donatukas/Malahit/D.jpg

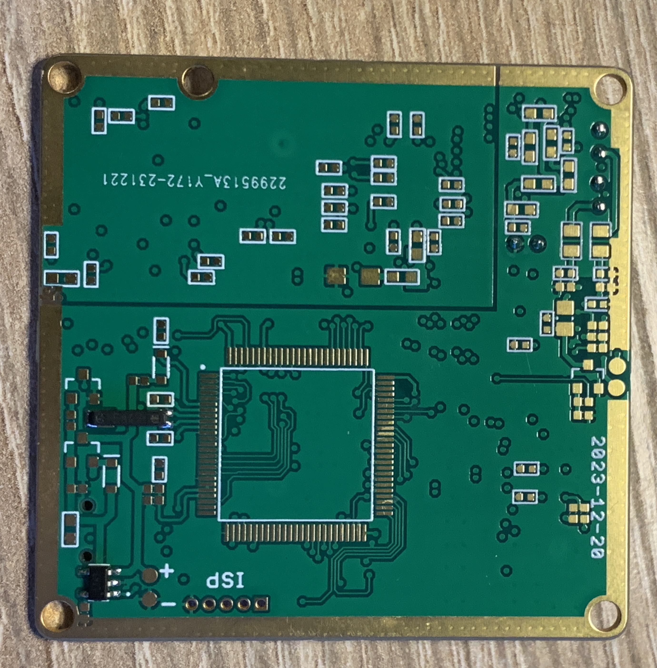
D.jpg
