donatukas/Malahit/C.jpg

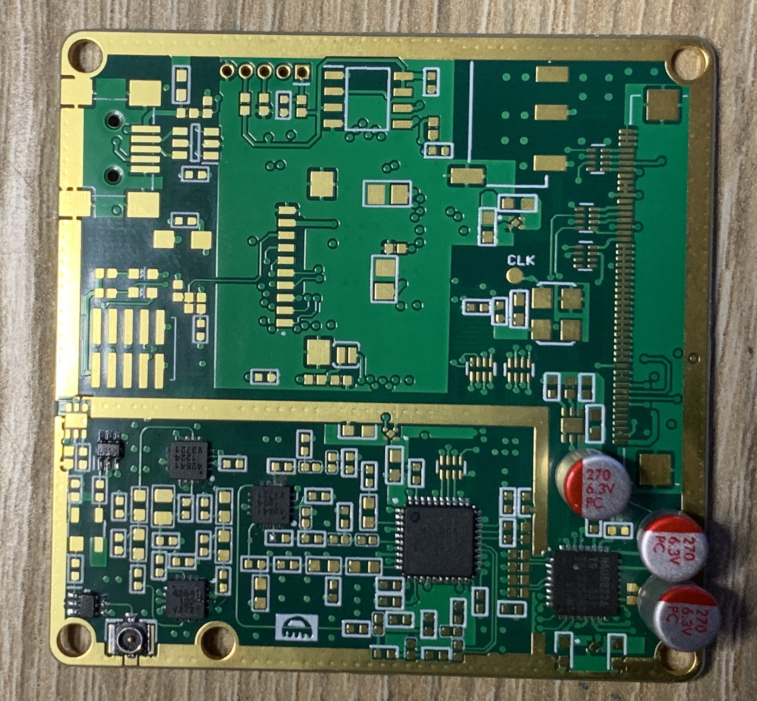
C.jpg
