donatukas/Malahit/README.md

     * Malachite SDR

     * 50KHz-250MHz+400-2000MHz DSP SDR Receiver
     * DSP SDR Receiver for Malahit
     * Capacitive touch screen
     * Flash via USB cable
     * Default frequency range: 50KHz-2000MHz
     * 3.5 inch capacitive screen
