donatukas/Malahit/A.png

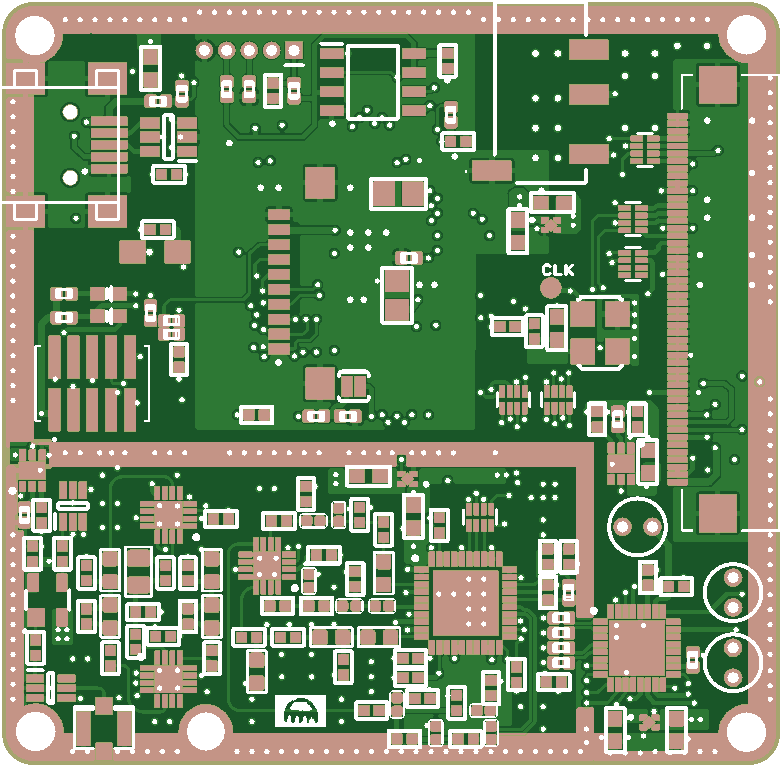
A.png
