donatukas/Malahit/B.png

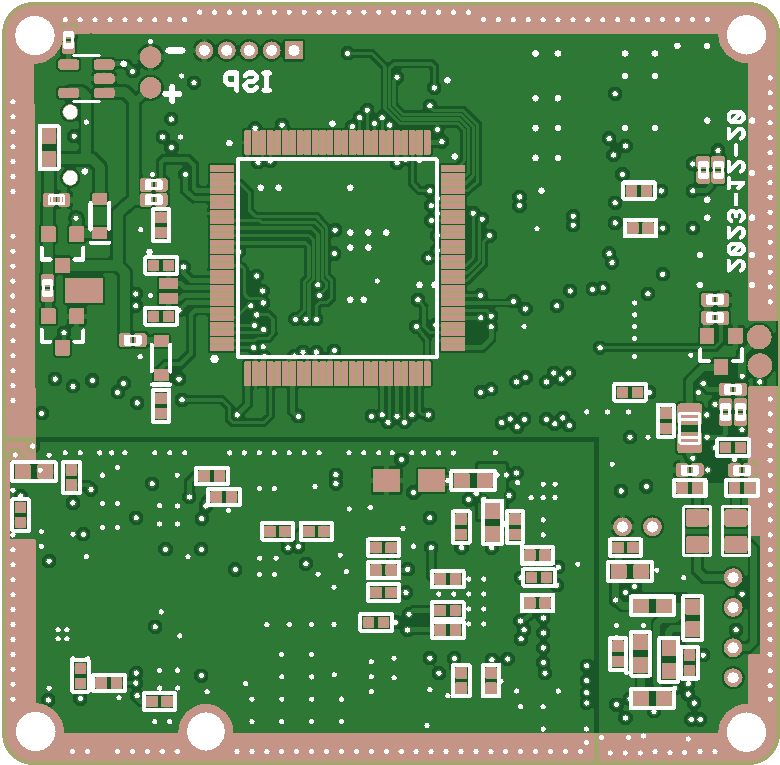
B.png
