donatukas/Malahit/schematic.pdf

+3V3 | +3V³
GND | GND GND

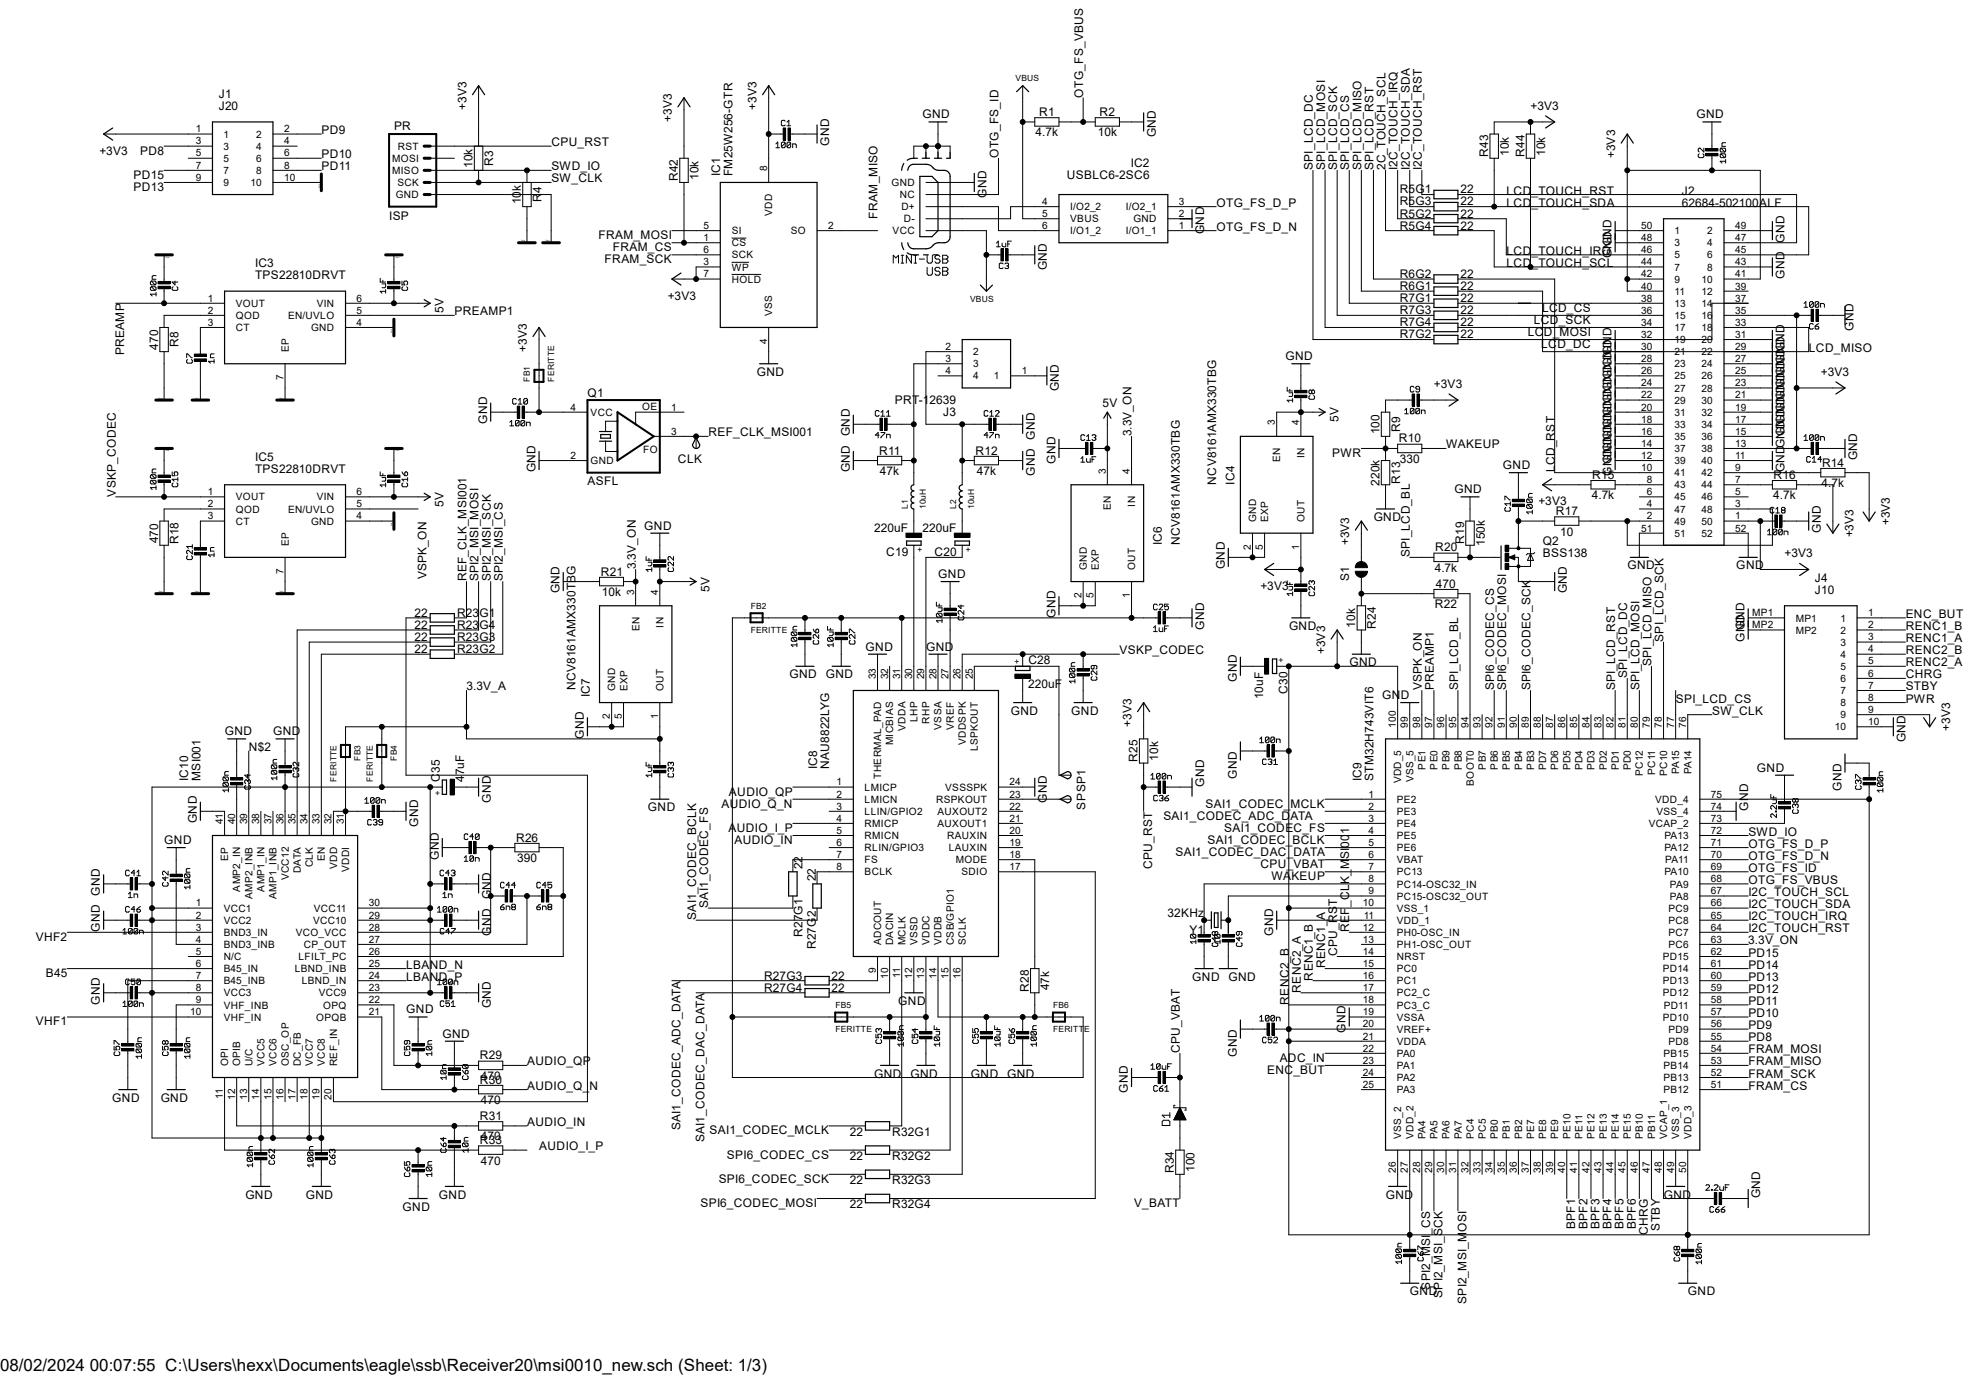
[picture p5: page 1]

4 SI 5 SCK 6 HOLD 7 VDD

7 VIN 6 EN/UVLO 5 GND 4

25 26 | 25
27 24 | 23
29 22 | 21

33 18 | 17
35 16 | 15
37 14 | 13

49 2 | 1
51 51 | 52

51 VDD_5 100 VSS_5 99 PE¹ ⁹⁸ PE⁰ ⁹⁷ PB⁹ ⁹⁶ PB⁸ ⁹⁵ BOOT0 94 PB⁷ ⁹³ PB⁶ ⁹² PB⁵ ⁹¹ PB⁴ ⁹⁰ PB³ ⁸⁹ PD⁷ ⁸⁸ PD⁶ ⁸⁷ PD⁵ ⁸⁶ PD⁴ ⁸⁵ PD³ ⁸⁴ PD² ⁸³ PD¹ ⁸² PD⁰ ⁸¹ PC¹² ⁸⁰ PC¹¹ ⁷⁹ PC¹⁰ ⁷⁸ PA¹⁵ ⁷⁷ PA¹⁴ ⁷⁶ IC⁹

9 DACIN 10 MCLK 11 VSSD 12 VDDC 13 VDDB 14 CSB/GPIO1 15 SCLK 16 VSSSPK 24 RSPKOUT 23 AUXOUT2 22 AUXOUT1 21 RAUXIN 20

FB6 FERITTE R²⁸ R²⁷G¹ R²⁷G²

08/02/2024 00:07:55 C:\Users\hexx\Documents\eagle\ssb\Receiver20\msi0010_new.sch (Sheet: 1/3)

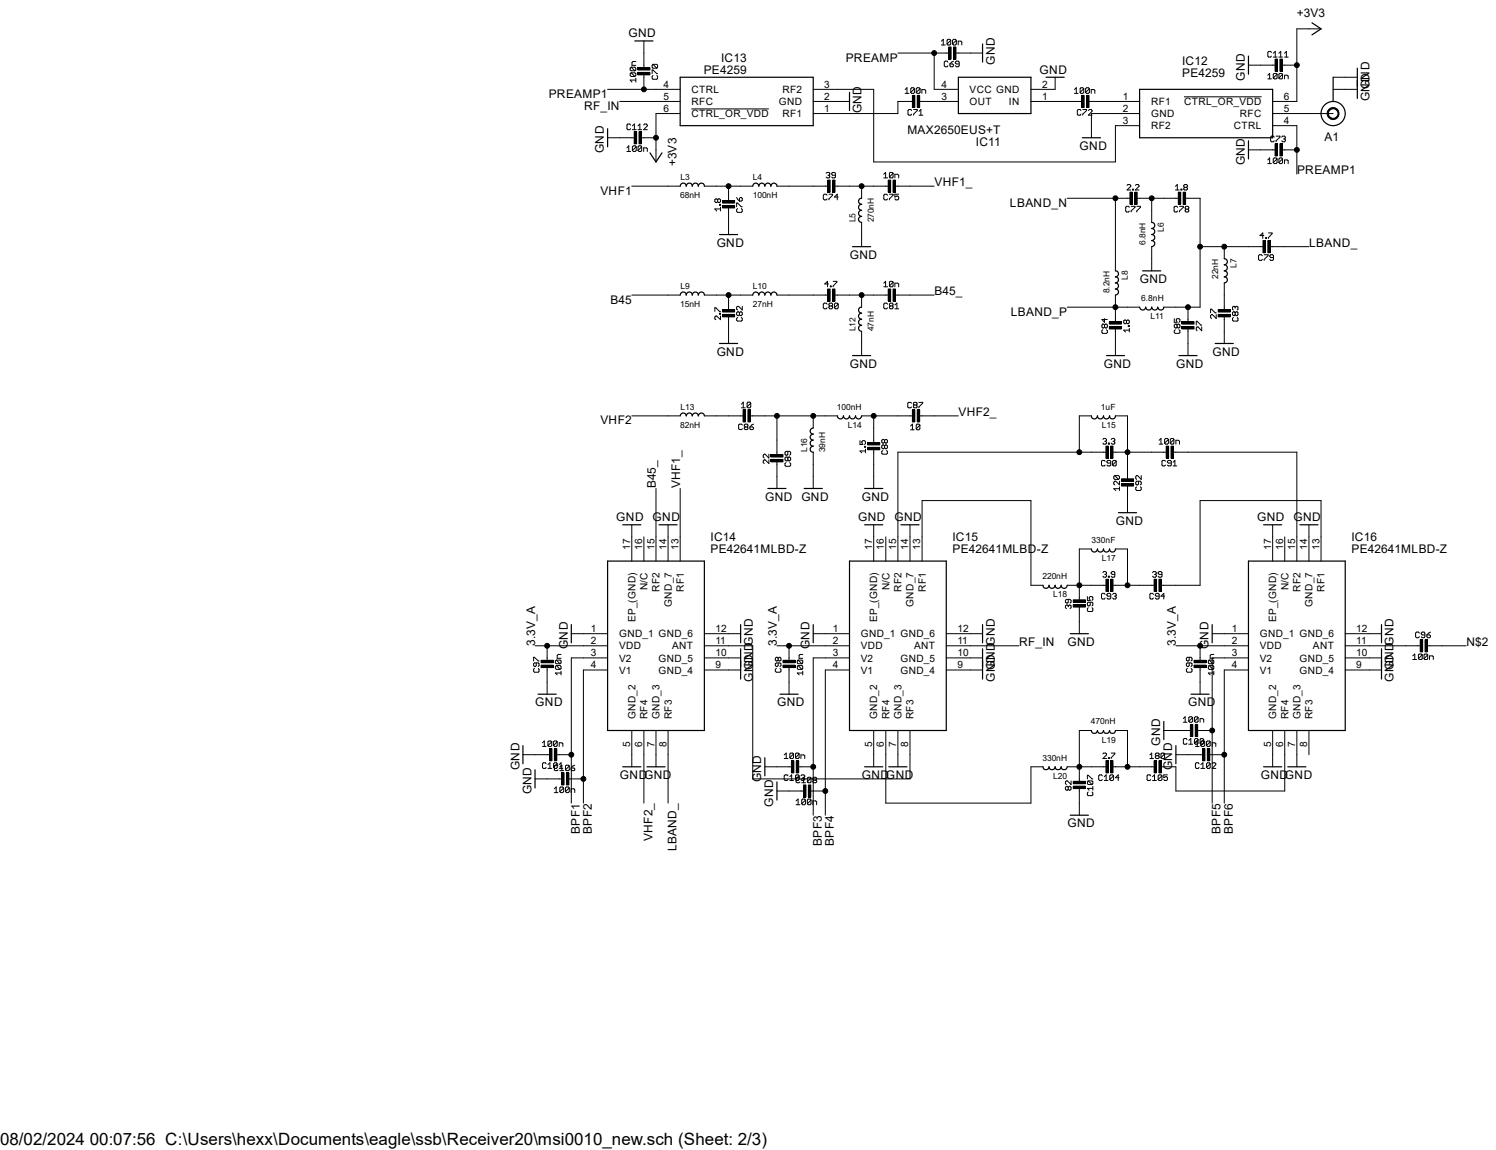
[picture p6: page 2]

8 GND_6 12 ANT 11 GND_5 10 GND_4 9 EP_(GND) 17 N/C 16 RF2 15 GND_7 14 RF1 13 RF1 1 GND 2 RF2 3 CTRL_OR_VDD 6 RFC 5 CTRL 4

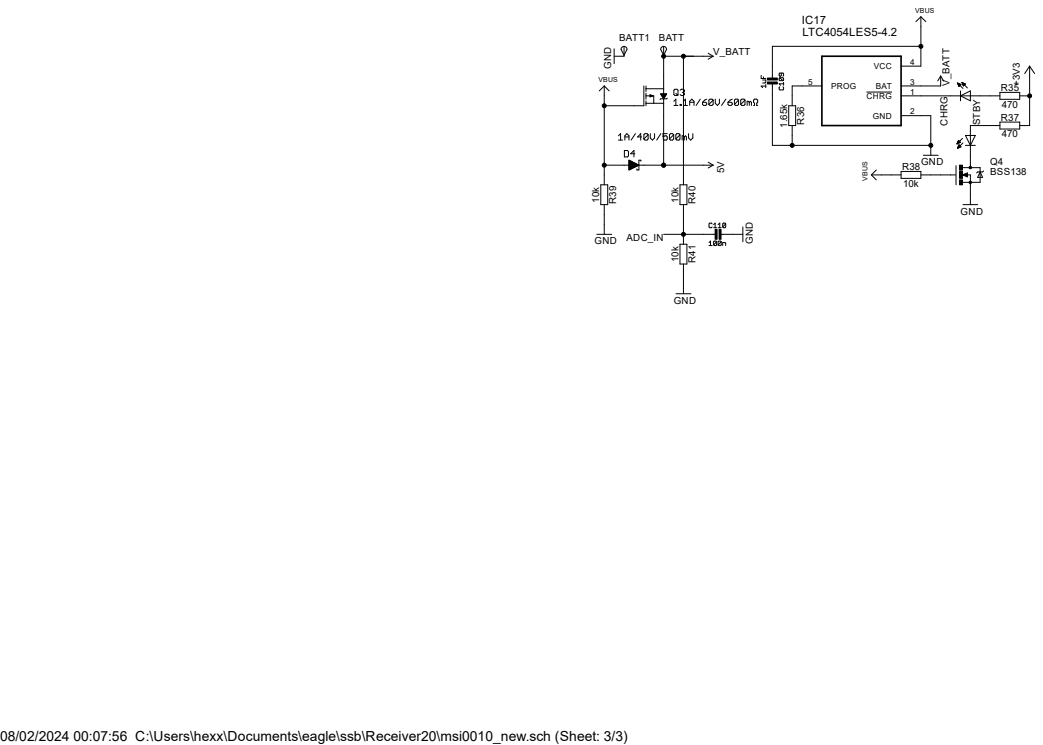
[picture p7: page 3]
V_BATT; LTC4054LES5-4.2; V_BATT 10k; GND; VBUS; BSS138; GND VBUS; +3V³ GND; VCC; 4 PROG 5; 2 BAT; 3 CHRG; IC17 R³⁹; R³⁶; BATT1; CHRG; ADC_IN; STBY

VBUS 10k 10k GND
BATT R⁴⁰ R⁴¹

08/02/2024 00:07:56 C:\Users\hexx\Documents\eagle\ssb\Receiver20\msi0010_new.sch (Sheet: 3/3)
