donatukas/Malahit/gerber/msi0010_new.brd

## EAGLE design gerber/msi0010_new.brd (2024-02-08)

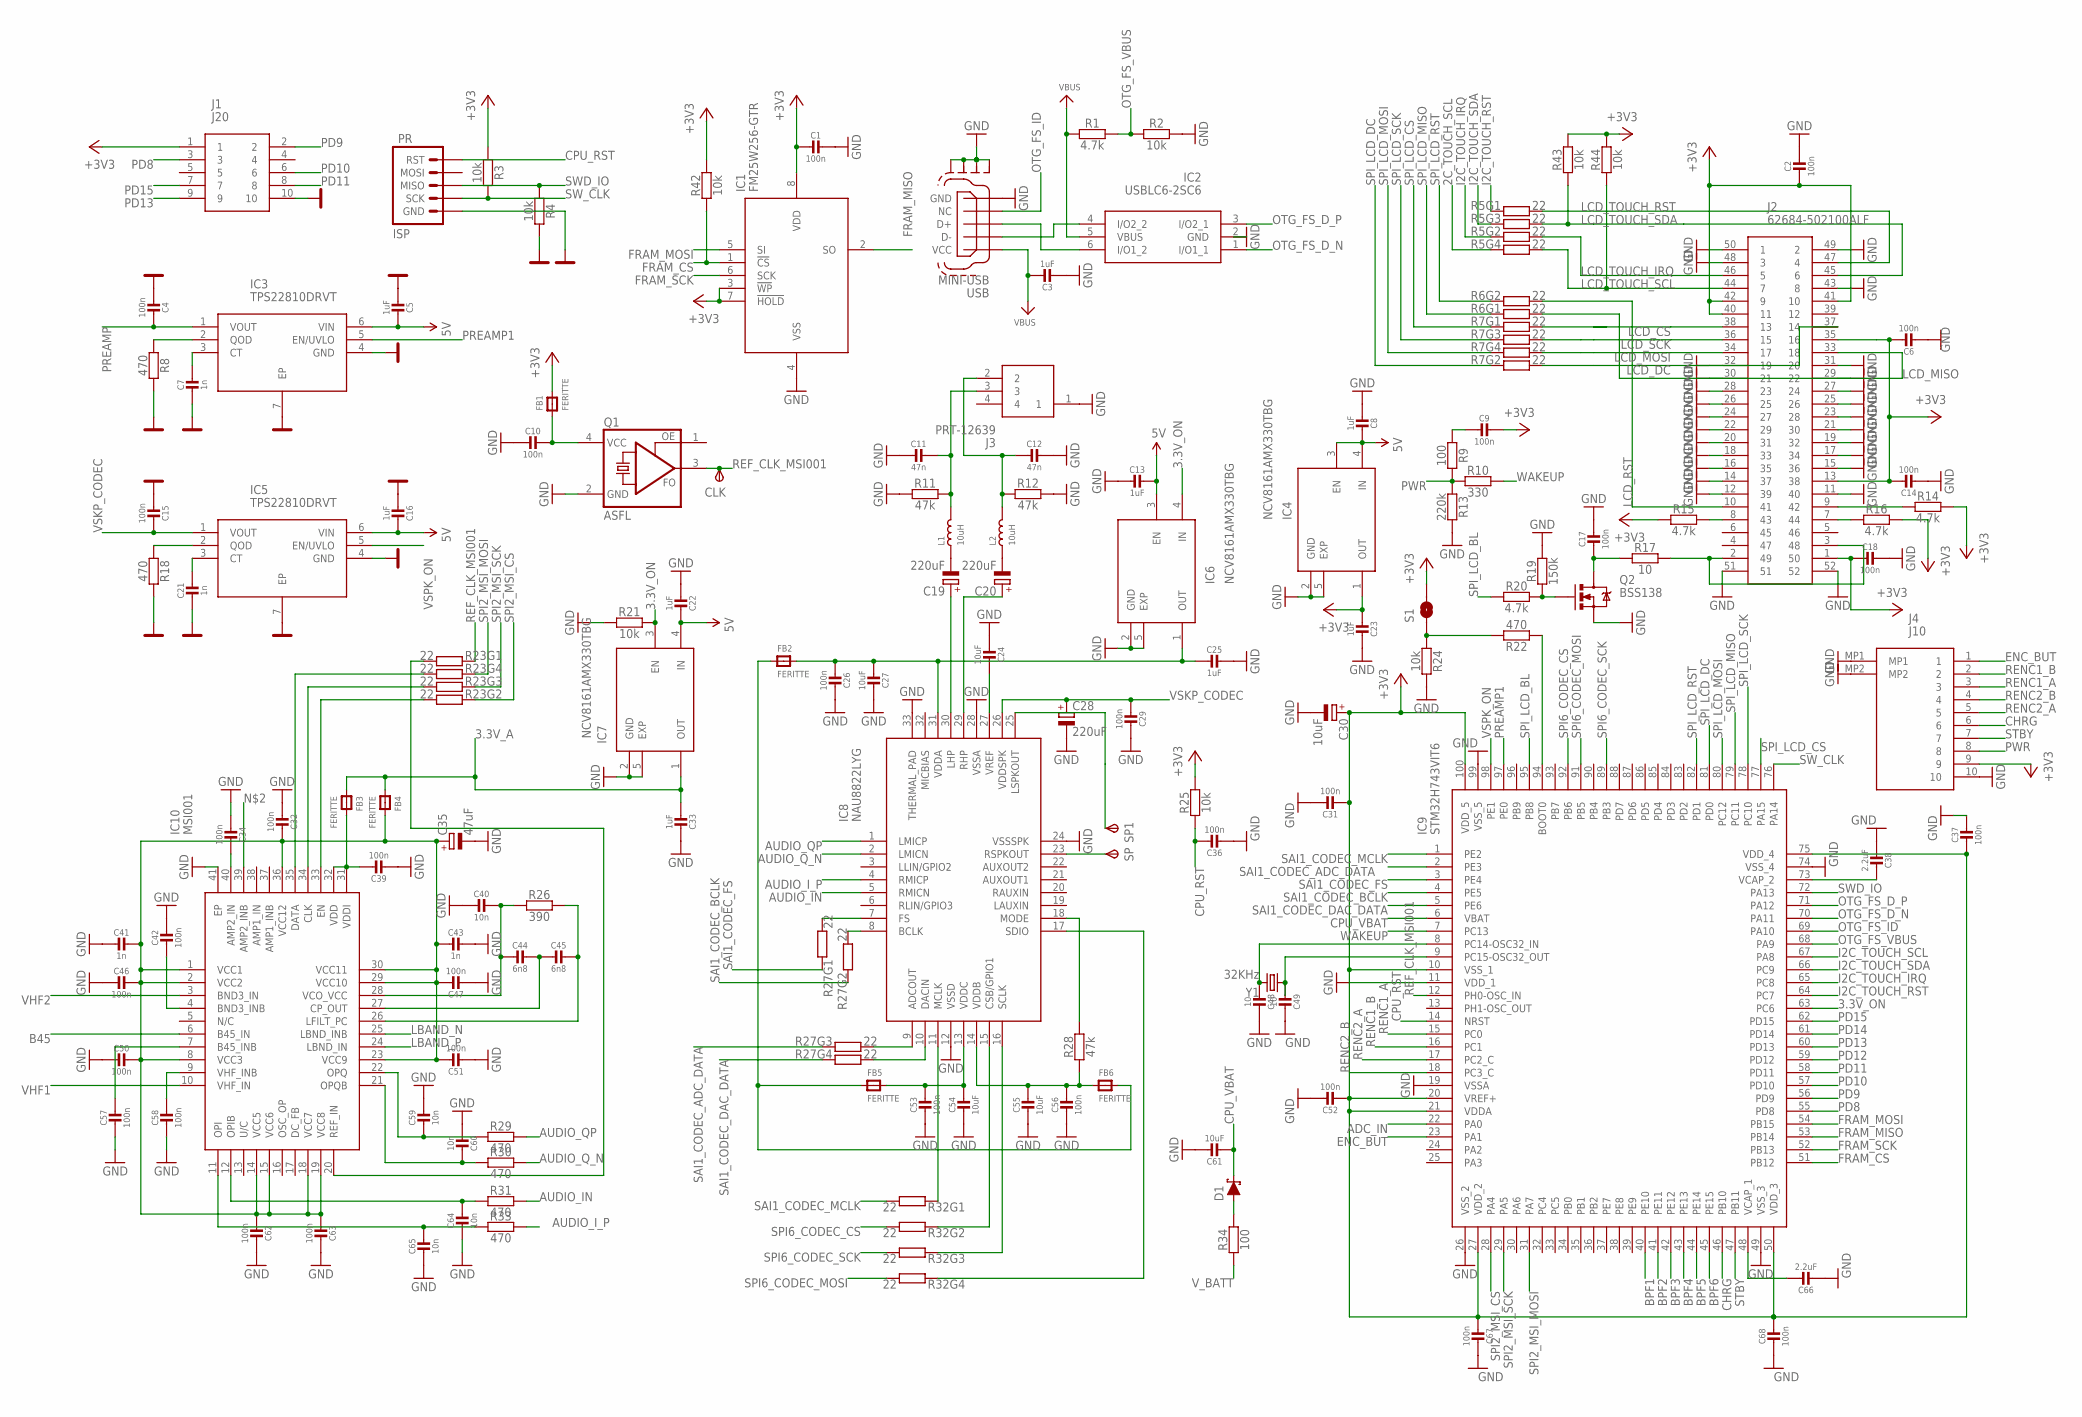
[picture p8: schematic msi0010_new.sch, sheet 1]

Parts:
C1, C2, C4, C6, C9, C10, C14, C15, C17, C18, C29, C31, C32, C34, C36, C37, C39, C42, C46, C47, C50, C51, C52, C53, C57, C58, C62, C63, C67, C68: 100n; _0402
C3, C5, C8, C13, C16, C22, C23, C25, C33: 1uF; _0603
C7, C21, C41, C43: 1n; _0402
C11, C12: 47n; _0402
C19, C20, C28: 220uF; SANYO-OSCON_A
C24, C27, C55, C61: 10uF; _0402
C26, C56: 100n; _0603
C30: 10uF; SMC_A
C35: 47uF; SMC_A
C38, C66: 2.2uF; 0805_NOTHERMALS
C40, C59, C60, C64, C65: 10n; _0402
C44, C45: 6n8; _0402
C48, C49: 10; _0402
C54: 10uF; _0603
CLK: TPSTP13R; TP13R
D1: 1A/40V/500mV; SOD-323
FB1, FB2, FB3, FB4, FB5, FB6: FERITTE; _0603
IC1: FM25W256-GTR; SOT127P602X173-8N
IC2: USBLC6-2SC6; SOT95P280X145-6N
IC3, IC5: TPS22810DRVT; SON65P200X200X80-7N
IC4, IC6, IC7: NCV8161AMX330TBG; VREG_NCP170AMX285TCG
IC8: NAU8822LYG; QFN50P500X500X80-33N
IC9: STM32H743VIT6; QFP50P1600X1600X160-100N
IC10: MSI001; QFN50P600X600X90-41N
J1: J20; 3220-10-0300-00-TR_322010030000TR
J2: 62684-502100ALF; 62684502100ALF
J3: PRT-12639; PRT12639
J4: J10; 686120148922_686120148922
L1, L2: 10uH; L0805@1
PR: ISP; SPARKFUN-CONNECTORS_PIC-ICSP-MINI
Q1: ASFL; ASF
Q2: BSS138; SOT23-3
R1, R14, R15, R16, R20: 4.7k; C0402
R2, R3, R4, R21, R24, R25, R42, R43, R44: 10k; C0402
R5, R6, R7, R23, R27, R32: 22; R_MATRIX_4_0402
R8, R18, R22, R29, R30, R31, R33: 470; C0402
R9, R34: 100; C0402
R10: 330; C0402
R11, R12, R28: 47k; C0402
R13: 220k; C0402
R17: 10; C0805
R19: 150k; C0402
R26: 390; C0402
S1: SOLDERJUMPERNO; SJ_2S-NO
SP, SP1: TPSTP15R; TP15R
USB: MINI-USB; MINI-USB-B5
Y1: 32KHz; CRYSTAL-32KHZ-MS3V

Connections:
2C_TOUCH_SCL: R5.4.1 (1)
3.3V_A: C33.2, FB3.1, FB4.1, IC7.1 (OUT); also elsewhere on the board
3.3V_ON: IC6.4 (IN), IC7.3 (EN), IC9.63 (PC6), R21.2
5V: C5.1, C8.1, C13.1, C16.1, C22.1, IC3.6 (VIN), IC4.3 (EN), IC4.4 (IN), IC5.6 (VIN), IC6.3 (EN), IC7.4 (IN); also elsewhere on the board
+3V3: C1.2, C2.2, C6.1, C9.1, C14.1, C18.2, C23.2, C30.+, C31.2, C37.2, C52.2, C67.2, C68.1, FB1.2, IC1.3 (!WP), IC1.7 (!HOLD), IC1.8 (VDD), IC4.1 (OUT), IC9.10 (VSS_1), IC9.20 (VREF+), IC9.21 (VDDA), IC9.27 (VDD_2), IC9.50 (VDD_3), IC9.75 (VDD_4), IC9.100 (VDD_5), J1.1, J2.1 (50), J2.13 (38), J2.35 (16), J2.40 (11), J2.41 (10), J2.42 (9), J4.9, R3.1, R14.2, R15.1, R16.2, R25.2, R42.2, R43.2, R44.2, S1.2; also elsewhere on the board
-: IC8.25 (LSPKOUT), SP1.TP
ADC_IN: IC9.22 (PA0); also elsewhere on the board
AUDIO_IN: IC8.5 (RMICN), R31.2
AUDIO_I_P: IC8.4 (RMICP), R33.2
AUDIO_QP: IC8.1 (LMICP), R29.2
AUDIO_Q_N: IC8.2 (LMICN), R30.2
B45: IC10.6 (B45_IN); also elsewhere on the board
BPF1: IC9.40 (PE10); also elsewhere on the board
BPF2: IC9.41 (PE11); also elsewhere on the board
BPF3: IC9.42 (PE12); also elsewhere on the board
BPF4: IC9.43 (PE13); also elsewhere on the board
BPF5: IC9.44 (PE14); also elsewhere on the board
BPF6: IC9.45 (PE15); also elsewhere on the board
CHRG: IC9.46 (PB10), J4.6; also elsewhere on the board
CPU_RST: C36.1, IC9.14 (NRST), PR.1 (RST), R25.1
CPU_VBAT: C61.2, D1.C, IC9.6 (VBAT)
ENC_BUT: IC9.23 (PA1), J4.1
FRAM_CS: IC1.1 (!CS), IC9.51 (PB12), R42.1
FRAM_MISO: IC1.2 (SO), IC9.53 (PB14)
FRAM_MOSI: IC1.5 (SI), IC9.54 (PB15)
FRAM_SCK: IC1.6 (SCK), IC9.52 (PB13)
GND: C1.1, C2.1, C3.2, C4.2, C5.2, C6.2, C7.2, C8.2, C10.2, C11.2, C12.1, C13.2, C14.2, C15.2, C16.2, C17.1, C18.1, C21.2, C22.2, C23.1, C24.2, C25.1, C26.1, C27.1, C28.-, C29.1, C30.-, C31.1, C32.2, C33.1, C34.2, C35.-, C36.2, C37.1, C38.2, C39.2, C40.2, C41.2, C42.1, C43.1, C46.2, C47.2, C48.1, C49.1, C50.2, C51.2, C52.1, C53.2, C54.2, C55.2, C56.2, C57.2, C58.2, C59.1, C60.2, C61.1, C62.1, C63.1, C64.2, C65.2, C66.2, C67.1, C68.2, IC1.4 (VSS), IC2.2 (GND), IC3.4 (GND), IC3.7 (EP), IC4.2 (GND), IC4.5 (EXP), IC5.4 (GND), IC5.7 (EP), IC6.2 (GND), IC6.5 (EXP), IC7.2 (GND), IC7.5 (EXP), IC8.12 (VSSD), IC8.24 (VSSSPK), IC8.28 (VSSA), IC8.33 (THERMAL_PAD), IC9.11 (VDD_1), IC9.19 (VSSA), IC9.26 (VSS_2), IC9.49 (VSS_3), IC9.74 (VSS_4), IC9.99 (VSS_5), IC10.41 (EP), J1.10, J2.11 (40), J2.12 (39), J2.14 (37), J2.15 (36), J2.16 (35), J2.17 (34), J2.18 (33), J2.19 (32), J2.20 (31), J2.21 (30), J2.22 (29), J2.23 (28), J2.24 (27), J2.25 (26), J2.26 (25), J2.27 (24), J2.28 (23), J2.29 (22), J2.30 (21), J2.31 (20), J2.32 (19), J2.43 (8), J2.48 (3), J2.49 (2), J2.50 (1), J2.51, J2.52, J3.1, J4.10, J4.MP1, J4.MP2, PR.5 (GND), Q1.2 (GND), Q2.2 (S), R2.2, R4.2, R8.2, R11.1, R12.2, R13.2, R18.2, R19.2, R21.1, R24.2, USB.5 (GND), USB.M1 (S1), USB.M2 (S2), USB.M3 (S3), USB.M4 (S4); also elsewhere on the board
I2C_TOUCH_IRQ: IC9.65 (PC8), R5.2.1 (1)
I2C_TOUCH_RST: IC9.64 (PC7), R5.1.1 (1)
I2C_TOUCH_SCL: IC9.67 (PA8)
I2C_TOUCH_SDA: IC9.66 (PC9), R5.3.1 (1)
IO15: C48.2, IC9.8 (PC14-OSC32_IN), Y1.P$2 (2)
IO16: C49.2, IC9.9 (PC15-OSC32_OUT), Y1.P$1 (1)
LBAND_N: IC10.25 (LBND_INB); also elsewhere on the board
LBAND_P: IC10.24 (LBND_IN); also elsewhere on the board
LCD_CS: J2.38 (13), R7.1.2 (2)
LCD_DC: J2.37 (14), R7.2.2 (2)
LCD_MISO: J2.33 (18), R6.1.2 (2)
LCD_MOSI: J2.34 (17), R7.4.2 (2)
LCD_RST: J2.10 (41), R6.2.2 (2)
LCD_SCK: J2.36 (15), R7.3.2 (2)
LCD_TOUCH_IRQ: J2.46 (5), R5.2.2 (2)
LCD_TOUCH_RST: J2.47 (4), R5.1.2 (2)
LCD_TOUCH_SCL: J2.44 (7), R5.4.2 (2), R44.1
LCD_TOUCH_SDA: J2.45 (6), R5.3.2 (2), R43.1
unnamed: C34.1, IC10.40 (AMP2_IN)
unnamed 48: IC10.39 (AMP2_INB); also elsewhere on the board
unnamed: C39.1, FB3.2, IC10.31 (VDDI), IC10.32 (VDD)
unnamed: C32.1, C35.+, C41.1, C43.2, C46.1, C47.1, C50.1, C51.1, C62.2, C63.2, FB4.2, IC10.1 (VCC1), IC10.2 (VCC2), IC10.8 (VCC3), IC10.14 (VCC5), IC10.15 (VCC6), IC10.18 (VCC7), IC10.19 (VCC8), IC10.23 (VCC9), IC10.29 (VCC10), IC10.30 (VCC11), IC10.36 (VCC12)
unnamed: C64.1, IC10.12 (OPIB), R31.1
unnamed: C65.1, IC10.11 (OPI), R33.1
unnamed: C60.1, IC10.21 (OPQB), R30.1
unnamed: C59.2, IC10.22 (OPQ), R29.1
unnamed: C21.1, IC5.3 (CT)
unnamed: C10.1, FB1.1, Q1.4 (VCC)
unnamed: C42.2, IC10.4 (BND3_INB)
unnamed: C58.1, IC10.9 (VHF_INB)
unnamed: C57.1, IC10.7 (B45_INB)
unnamed: IC10.33 (EN), R23.2.2 (2)
unnamed: IC10.34 (CLK), R23.3.2 (2)
unnamed: IC10.35 (DATA), R23.4.2 (2)
unnamed: C40.1, C44.2, IC10.28 (VCO_VCC), R26.1
unnamed: C44.1, C45.2, IC10.27 (CP_OUT)
unnamed: C45.1, IC10.26 (LFILT_PC), R26.2
unnamed: C19.+, IC8.30 (LHP)
unnamed: IC10.20 (REF_IN), R23.1.2 (2)
unnamed: C24.1, IC8.27 (VREF)
unnamed: C25.2, C26.2, C27.2, FB2.2, IC6.1 (OUT), IC8.31 (VDDA)
unnamed: C53.1, C54.1, FB5.2, IC8.13 (VDDC)
unnamed: FB2.1, FB5.1, FB6.2
unnamed: C55.1, C56.1, FB6.1, IC8.14 (VDDB), R28.1
unnamed: IC8.18 (MODE), R28.2
unnamed: C20.+, IC8.29 (RHP)
unnamed: IC8.7 (FS), R27.1.2 (2)
unnamed: IC8.8 (BCLK), R27.2.2 (2)
unnamed: IC8.9 (ADCOUT), R27.3.2 (2)
unnamed: IC8.10 (DACIN), R27.4.2 (2)
unnamed: C7.1, IC3.3 (CT)
unnamed: IC5.2 (QOD), R18.1
unnamed: IC8.15 (CSB/GPIO1), R32.2.1 (1)
unnamed: IC8.11 (MCLK), R32.1.1 (1)
unnamed: IC8.16 (SCLK), R32.3.1 (1)
unnamed: IC8.17 (SDIO), R32.4.1 (1)
unnamed: C19.-, L1.1
unnamed: C20.-, L2.1
unnamed: C12.2, J3.2, L2.2, R12.1
unnamed: IC3.2 (QOD), R8.1
unnamed: C11.1, J3.3, L1.2, R11.2
unnamed: IC2.6 (I/O1_2), USB.3 (D+)
unnamed: J2.2 (49), J2.3 (48), R17.2
unnamed: J2.7 (44), R16.1
unnamed: C17.2, Q2.3 (D), R17.1
unnamed: Q2.1 (G), R19.1, R20.2
unnamed: J2.9 (42), R14.1
unnamed: J2.8 (43), R15.2
unnamed: C66.1, IC9.48 (VCAP_1)
unnamed: C38.1, IC9.73 (VCAP_2)
unnamed: IC8.23 (RSPKOUT), SP.TP
unnamed: IC2.4 (I/O2_2), USB.2 (D-)
unnamed: R22.2, R24.1, S1.1
unnamed: IC9.94 (BOOT0), R22.1
unnamed: C9.2, R9.1
OTG_FS_D_N: IC2.1 (I/O1_1), IC9.70 (PA11)
OTG_FS_D_P: IC2.3 (I/O2_1), IC9.71 (PA12)
OTG_FS_ID: IC9.69 (PA10), USB.4 (NC)
OTG_FS_VBUS: IC9.68 (PA9), R1.2, R2.1
PD8: IC9.55 (PD8), J1.3
PD9: IC9.56 (PD9), J1.2
PD10: IC9.57 (PD10), J1.6
PD11: IC9.58 (PD11), J1.8
PD12: IC9.59 (PD12)
PD13: IC9.60 (PD13), J1.9
PD14: IC9.61 (PD14)
PD15: IC9.62 (PD15), J1.7
PREAMP: C4.1, IC3.1 (VOUT); also elsewhere on the board
PREAMP1: IC3.5 (EN/UVLO), IC9.97 (PE0); also elsewhere on the board
PWR: J4.8, R9.2, R10.1, R13.1
REF_CLK_MSI001: CLK.TP, IC9.12 (PH0-OSC_IN), Q1.3 (FO), R23.1.1 (1)
RENC1_A: IC9.15 (PC0), J4.3
RENC1_B: IC9.16 (PC1), J4.2
RENC2_A: IC9.17 (PC2_C), J4.5
RENC2_B: IC9.18 (PC3_C), J4.4
SAI1_CODEC_ADC_DATA: IC9.2 (PE3), R27.3.1 (1)
SAI1_CODEC_BCLK: IC9.4 (PE5), R27.2.1 (1)
SAI1_CODEC_DAC_DATA: IC9.5 (PE6), R27.4.1 (1)
SAI1_CODEC_FS: IC9.3 (PE4), R27.1.1 (1)
SAI1_CODEC_MCLK: IC9.1 (PE2), R32.1.2 (2)
SPI2_MSI_CS: IC9.28 (PA4), R23.2.1 (1)
SPI2_MSI_MOSI: IC9.31 (PA7), R23.4.1 (1)
SPI2_MSI_SCK: IC9.29 (PA5), R23.3.1 (1)
SPI6_CODEC_CS: IC9.92 (PB6), R32.2.2 (2)
SPI6_CODEC_MOSI: IC9.91 (PB5), R32.4.2 (2)
SPI6_CODEC_SCK: IC9.89 (PB3), R32.3.2 (2)
SPI_LCD_BL: IC9.95 (PB8), R20.1
SPI_LCD_CS: IC9.77 (PA15), R7.1.1 (1)
SPI_LCD_DC: IC9.81 (PD0), R7.2.1 (1)
SPI_LCD_MISO: IC9.79 (PC11), R6.1.1 (1)
SPI_LCD_MOSI: IC9.80 (PC12), R7.4.1 (1)
SPI_LCD_RST: IC9.82 (PD1), R6.2.1 (1)
SPI_LCD_SCK: IC9.78 (PC10), R7.3.1 (1)
STBY: IC9.47 (PB11), J4.7; also elsewhere on the board
SWD_IO: IC9.72 (PA13), PR.3 (MISO), R4.1
SW_CLK: IC9.76 (PA14), PR.4 (SCK), R3.2
VBUS: C3.1, IC2.5 (VBUS), R1.1, USB.1 (VCC); also elsewhere on the board
VBUS1: D1.A, R34.2
VHF1: IC10.10 (VHF_IN); also elsewhere on the board
VHF2: IC10.3 (BND3_IN); also elsewhere on the board
VSKP_CODEC: C15.1, C28.+, C29.2, IC5.1 (VOUT), IC8.26 (VDDSPK)
VSPK_ON: IC5.5 (EN/UVLO), IC9.98 (PE1)
V_BATT: R34.1; also elsewhere on the board
WAKEUP: IC9.7 (PC13), R10.2

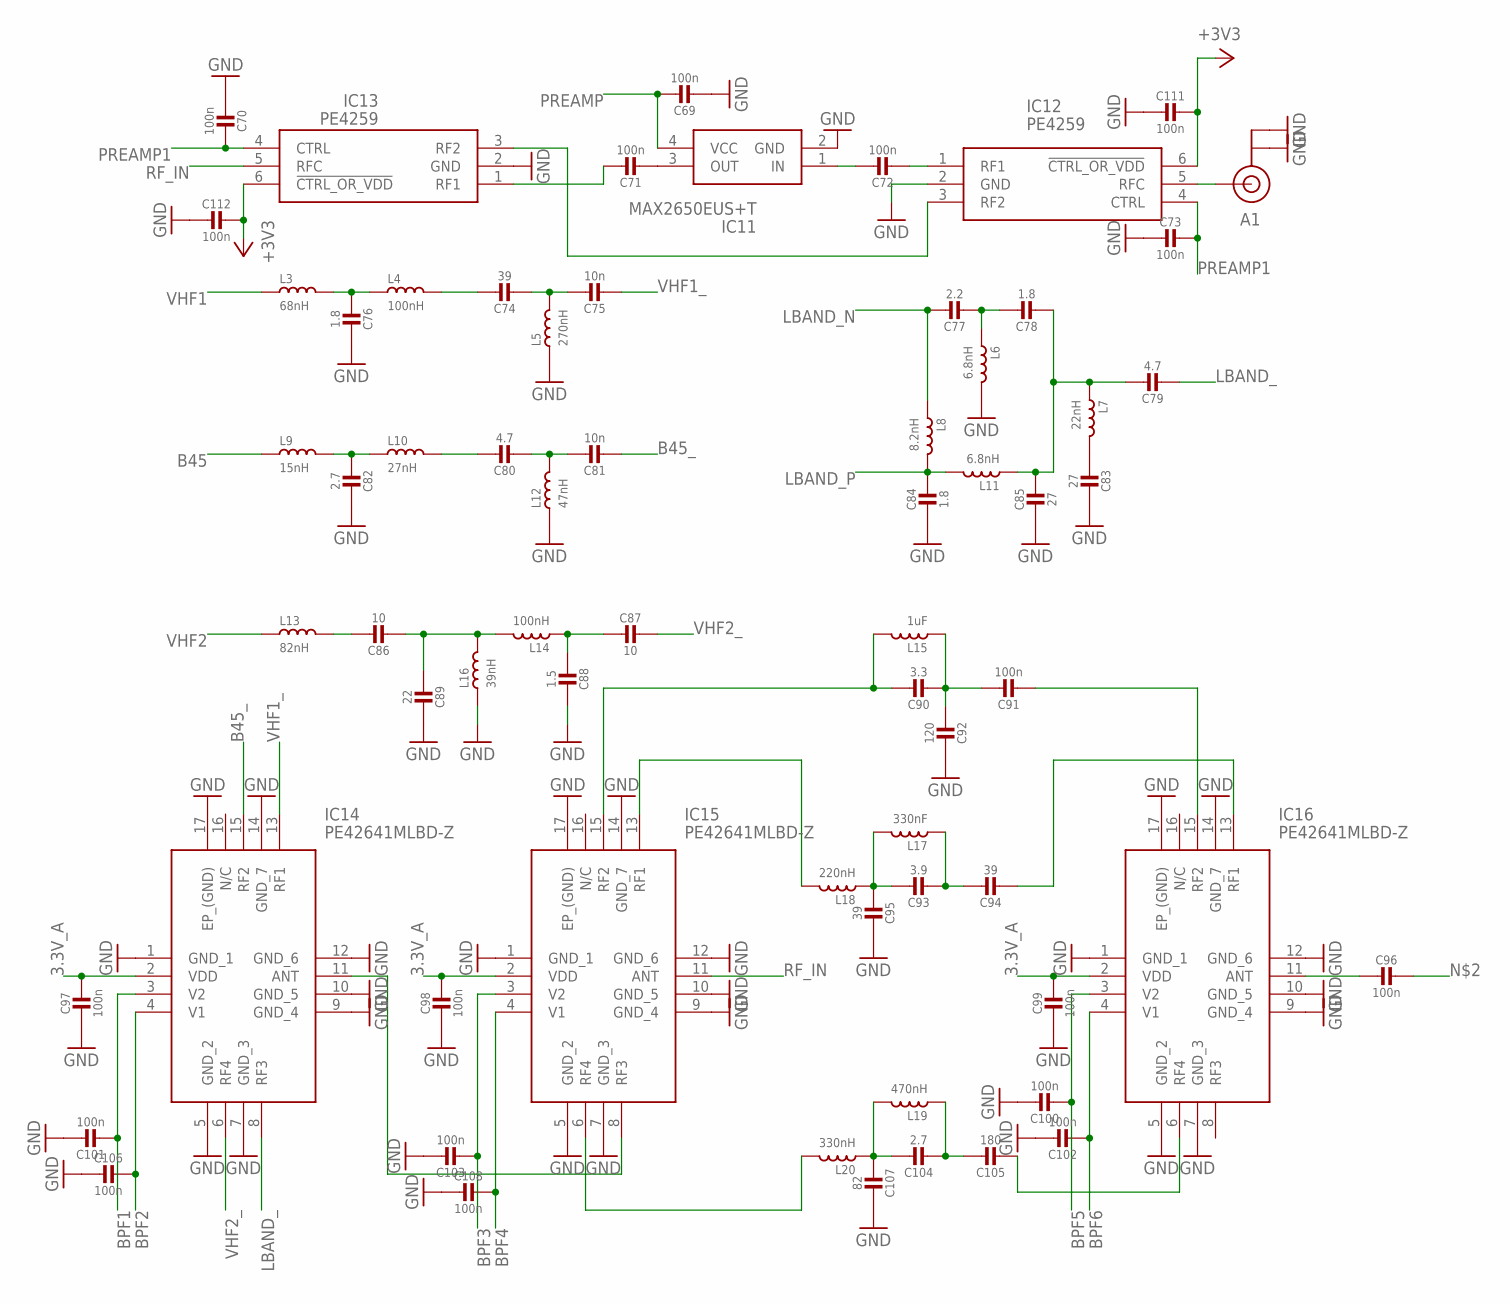
[picture p9: schematic msi0010_new.sch, sheet 2]

Parts:
A1: U.FL
C69, C70, C71, C72, C73, C91, C96, C97, C98, C99, C100, C101, C102, C103, C106, C108, C111, C112: 100n; _0402
C74, C94, C95: 39; _0402
C75, C81: 10n; _0402
C76, C78, C84: 1.8; _0402
C77: 2.2; _0402
C79, C80: 4.7; _0402
C82, C104: 2.7; _0402
C83, C85: 27; _0402
C86, C87: 10; _0402
C88: 1.5; _0402
C89: 22; _0402
C90: 3.3; _0402
C92: 120; _0402
C93: 3.9; _0402
C105: 180; _0402
C107: 82; _0402
IC11: MAX2650EUS+T; 4-SOT143
IC12: PE4259; SOT65P210X110-6N
IC13: PE4259; SOT65P210X110-6N; MANUFACTURER_PART_NUMBER PE4259; MOUSER_PART_NUMBER N/A
IC14: PE42641MLBD-Z; QFN50P300X300X80-17N
IC15, IC16: PE42641MLBD-Z; QFN50P300X300X80-17N; MANUFACTURER_PART_NUMBER PE42641MLBD-Z; MOUSER_PART_NUMBER 81-PE42641MLBD-Z
L3: 68nH; L0603@1
L4: 100nH; L0603@1
L5: 270nH; L0603@1
L6, L11: 6.8nH; L0402@1
L7: 22nH; L0402@1
L8: 8.2nH; L0402@1
L9: 15nH; L0402@1
L10: 27nH; L0402@1
L12: 47nH; L0402@1
L13: 82nH; L0603@1
L14: 100nH; L0402@1
L15: 1uF; L0805@1
L16: 39nH; L0402@1
L17: 330nF; L0603@1
L18: 220nH; L0603@1
L19: 470nH; L0603@1
L20: 330nH; L0603@1

Connections:
3.3V_A: C97.1, C98.1, C99.1, IC14.2 (VDD), IC15.2 (VDD), IC16.2 (VDD); also elsewhere on the board
+3V3: C111.1, C112.1, IC12.6 (!CTRL_OR_VDD), IC13.6 (!CTRL_OR_VDD); also elsewhere on the board
B45: L9.1; also elsewhere on the board
B45_: C81.2, IC14.15 (RF2)
BPF1: C101.2, IC14.3 (V2); also elsewhere on the board
BPF2: C106.1, IC14.4 (V1); also elsewhere on the board
BPF3: C103.2, IC15.3 (V2); also elsewhere on the board
BPF4: C108.1, IC15.4 (V1); also elsewhere on the board
BPF5: C100.2, IC16.3 (V2); also elsewhere on the board
BPF6: C102.2, IC16.4 (V1); also elsewhere on the board
GND: A1.P$1 (GND), A1.P$2 (GND), C69.2, C70.2, C73.2, C76.1, C82.1, C83.1, C84.2, C85.2, C88.1, C89.1, C92.1, C95.1, C97.2, C98.2, C99.2, C100.1, C101.1, C102.1, C103.1, C106.2, C107.1, C108.2, C111.2, C112.2, IC11.2 (GND), IC12.2 (GND), IC13.2 (GND), IC14.1 (GND_1), IC14.5 (GND_2), IC14.7 (GND_3), IC14.9 (GND_4), IC14.10 (GND_5), IC14.12 (GND_6), IC14.14 (GND_7), IC14.17 (EP_(GND)), IC15.1 (GND_1), IC15.5 (GND_2), IC15.7 (GND_3), IC15.9 (GND_4), IC15.10 (GND_5), IC15.12 (GND_6), IC15.14 (GND_7), IC15.17 (EP_(GND)), IC16.1 (GND_1), IC16.5 (GND_2), IC16.7 (GND_3), IC16.9 (GND_4), IC16.10 (GND_5), IC16.12 (GND_6), IC16.14 (GND_7), IC16.17 (EP_(GND)), L5.1, L6.2, L12.1, L16.1; also elsewhere on the board
LBAND_: C79.2, IC14.8 (RF3)
LBAND_N: C77.1, L8.1; also elsewhere on the board
LBAND_P: C84.1, L8.2, L11.2; also elsewhere on the board
unnamed 48: C96.1; also elsewhere on the board
unnamed: C71.1, IC13.1 (RF1)
unnamed: C82.2, L9.2, L10.1
unnamed: C78.2, C79.1, C85.1, L7.1, L11.1
unnamed: C80.1, L10.2
unnamed: C77.2, C78.1, L6.1
unnamed: C83.2, L7.2
unnamed: C80.2, C81.1, L12.2
unnamed: C76.2, L3.2, L4.1
unnamed: C74.1, L4.2
unnamed: C74.2, C75.1, L5.2
unnamed: IC14.11 (ANT), IC15.8 (RF3)
unnamed: C86.1, L13.2
unnamed: C86.2, C89.2, L14.2, L16.2
unnamed: C87.2, C88.2, L14.1
unnamed: C90.1, IC15.15 (RF2), L15.2
unnamed: C90.2, C91.1, C92.2, L15.1
unnamed: C72.1, IC11.1 (IN)
unnamed: C91.2, IC16.15 (RF2)
unnamed: C104.1, C107.2, L19.2, L20.1
unnamed: C104.2, C105.1, L19.1
unnamed: IC15.6 (RF4), L20.2
unnamed: C105.2, IC16.6 (RF4)
unnamed: C93.1, C95.2, L17.2, L18.1
unnamed: C93.2, C94.1, L17.1
unnamed: IC15.13 (RF1), L18.2
unnamed: C94.2, IC16.13 (RF1)
unnamed: C71.2, IC11.3 (OUT)
unnamed: C72.2, IC12.1 (RF1)
unnamed: A1.P$3 (SIGNAL), IC12.5 (RFC)
unnamed: C96.2, IC16.11 (ANT)
unnamed: IC12.3 (RF2), IC13.3 (RF2)
PREAMP: C69.1, IC11.4 (VCC); also elsewhere on the board
PREAMP1: C70.1, C73.1, IC12.4 (CTRL), IC13.4 (CTRL); also elsewhere on the board
RF_IN: IC13.5 (RFC), IC15.11 (ANT)
VHF1: L3.1; also elsewhere on the board
VHF1_: C75.2, IC14.13 (RF1)
VHF2: L13.1; also elsewhere on the board
VHF2_: C87.1, IC14.6 (RF4)

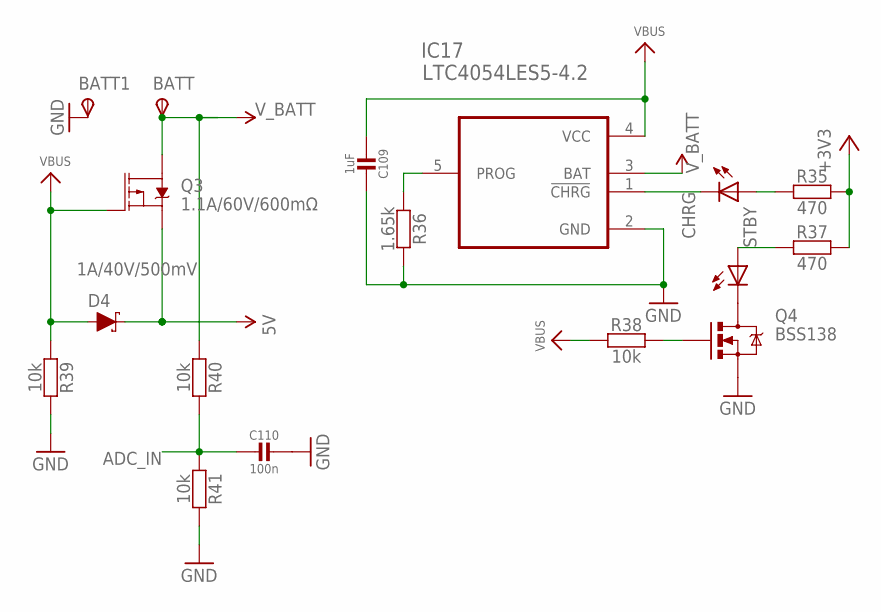
[picture p10: schematic msi0010_new.sch, sheet 3]

Parts:
BATT, BATT1: TPSTP13R; TP13R
C109: 1uF; _0603
C110: 100n; _0402
D2, D3: 1 led; LED-0603
D4: 1A/40V/500mV; SOD-323
IC17: LTC4054LES5-4.2; SOT95P280X100-5N
Q3: 1.1A/60V/600mΩ; SOT23-3@1
Q4: BSS138; SOT23-3
R35, R37: 470; C0402
R36: 1.65k; C0402
R38, R39, R40, R41: 10k; C0402

Connections:
5V: D4.C, Q3.2 (S); also elsewhere on the board
+3V3: R35.2, R37.2; also elsewhere on the board
ADC_IN: C110.2, R40.2, R41.1; also elsewhere on the board
CHRG: D2.C, IC17.1 (!CHRG); also elsewhere on the board
GND: BATT1.TP, C109.1, C110.1, IC17.2 (GND), Q4.2 (S), R36.2, R39.2, R41.2; also elsewhere on the board
unnamed: IC17.5 (PROG), R36.1
unnamed: D2.A, R35.1
unnamed: D3.C, Q4.3 (D)
unnamed: Q4.1 (G), R38.2
STBY: D3.A, R37.1; also elsewhere on the board
VBUS: C109.2, D4.A, IC17.4 (VCC), Q3.1 (G), R38.1, R39.1; also elsewhere on the board
V_BATT: BATT.TP, IC17.3 (BAT), Q3.3 (D), R40.1; also elsewhere on the board

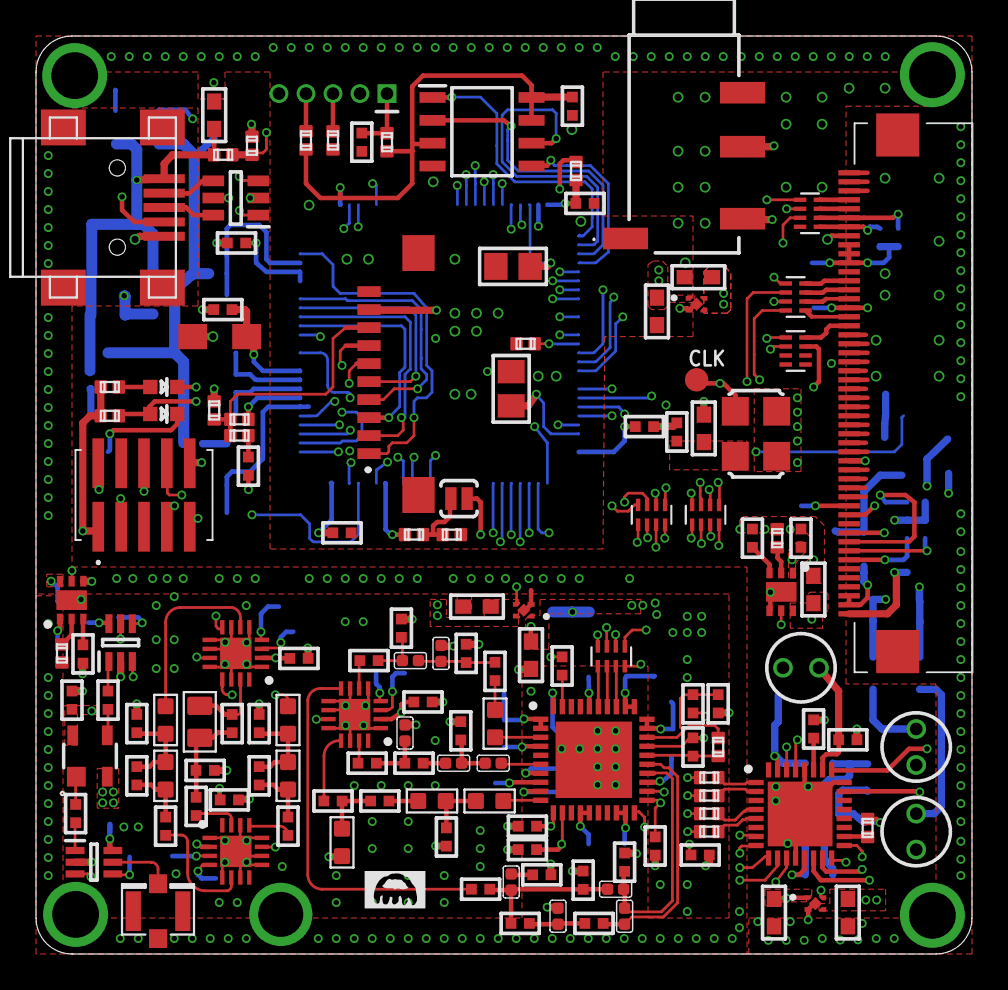
[picture p11: board msi0010_new.brd from above]

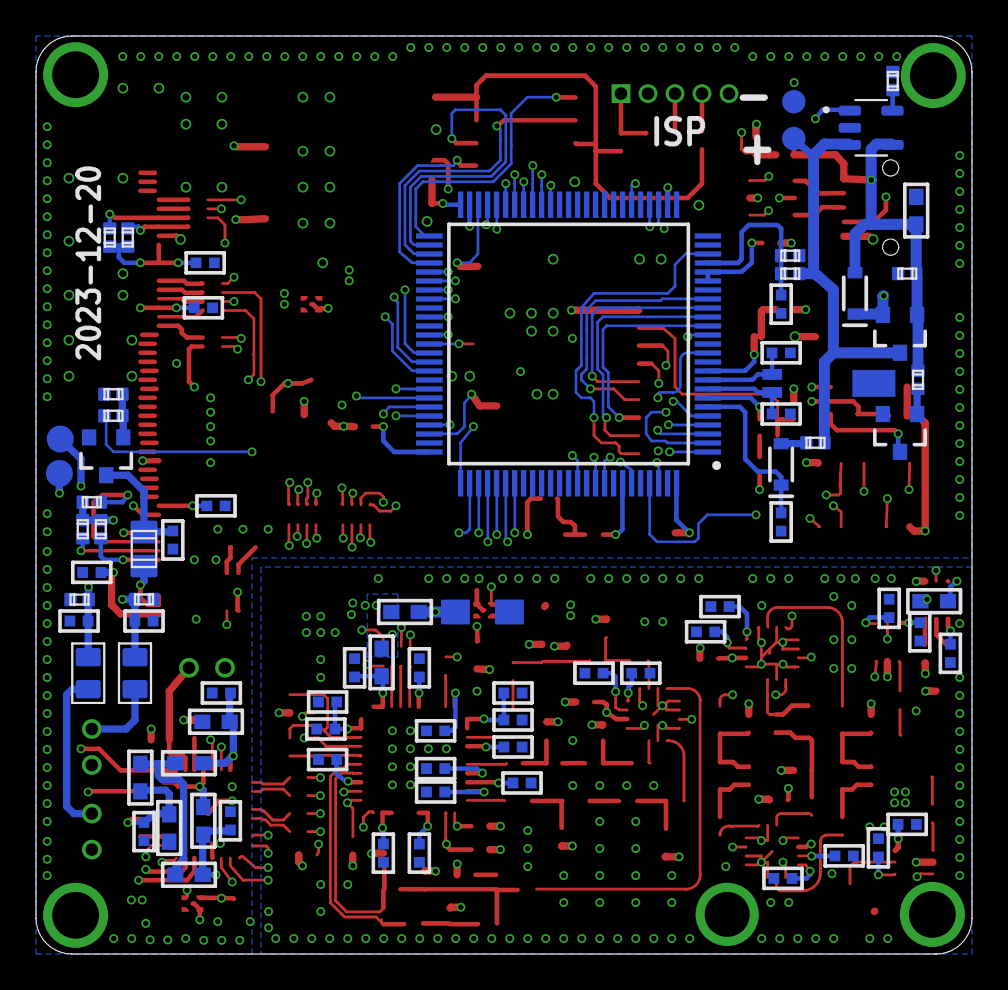
[picture p12: board msi0010_new.brd from below]

Board: 6 copper layers, 52.0 x 51.0 mm, 221 parts (80 on the bottom side), 187 nets.
